ZDBioHazard/IIDuinoX/iiduinox.sch

## KiCad design iiduinox.sch (2016-09-24)

Schematic: iiduinox.sch

Parts:
D1, D2, D3, D4, D5, D6, D7, D8, D9: RED
R1, R2, R3, R4, R5, R6, R7, R8, R9: 470
R10: 150
SW1: KEY_1
SW2: KEY_2
SW3: KEY_3
SW4: KEY_4
SW5: KEY_5
SW6: KEY_6
SW7: KEY_7
SW8: KEY_ST
SW9: KEY_SL
U1: SPARKFUN_PRO_MICRO; Sparkfun_Pro_Micro
U2, U3: ITR9608
