ZDBioHazard/IIDuinoX/(commit log)

2016-09-24 Initial commit.
    [iiduinox.sch]
2016-10-20 Make some turntable accuracy tweaks.
    * Tweak turntable timings.
    * Release the turntable key before pressing it again.
    * Disable interrupts while processing interrupts.
    * Return from the turntable reader early in some cases.
2016-11-16 Add a pre-built binary.
    This binary should work on ATMega32u4 boards.
    I'm using a Sparkfun Pro Micro clone.
